Killajoedotcom/Lerdge-iX/Pictures/With Pinda.jpg

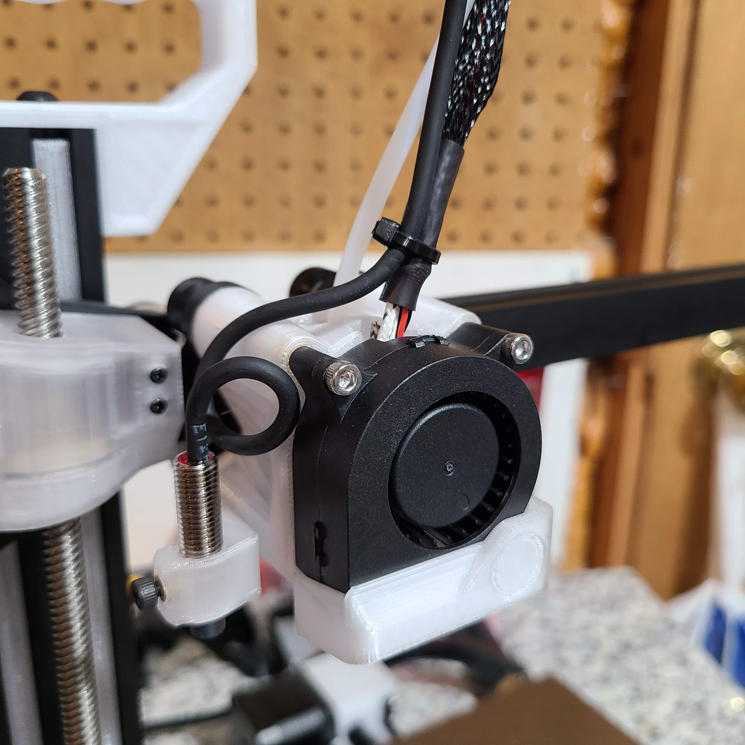
Pictures/With Pinda.jpg
