Killajoedotcom/Lerdge-iX/CAD/Lerdge Z Connections_2048x2048.jpg

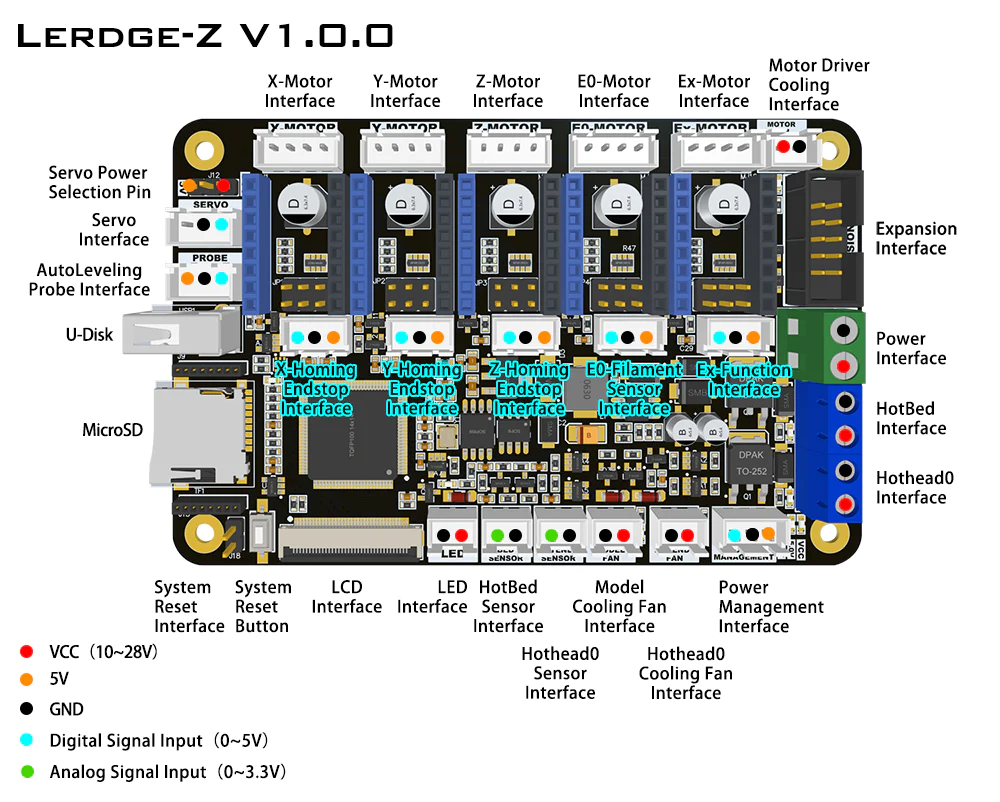
CAD/Lerdge Z Connections_2048x2048.jpg
