Killajoedotcom/Lerdge-iX/README.md

# Lerdge-iX
A repo for my Klipperized Lerdge iX
