Killajoedotcom/Lerdge-iX/CAD/3.5_screen_size-1000_2048x2048.jpg

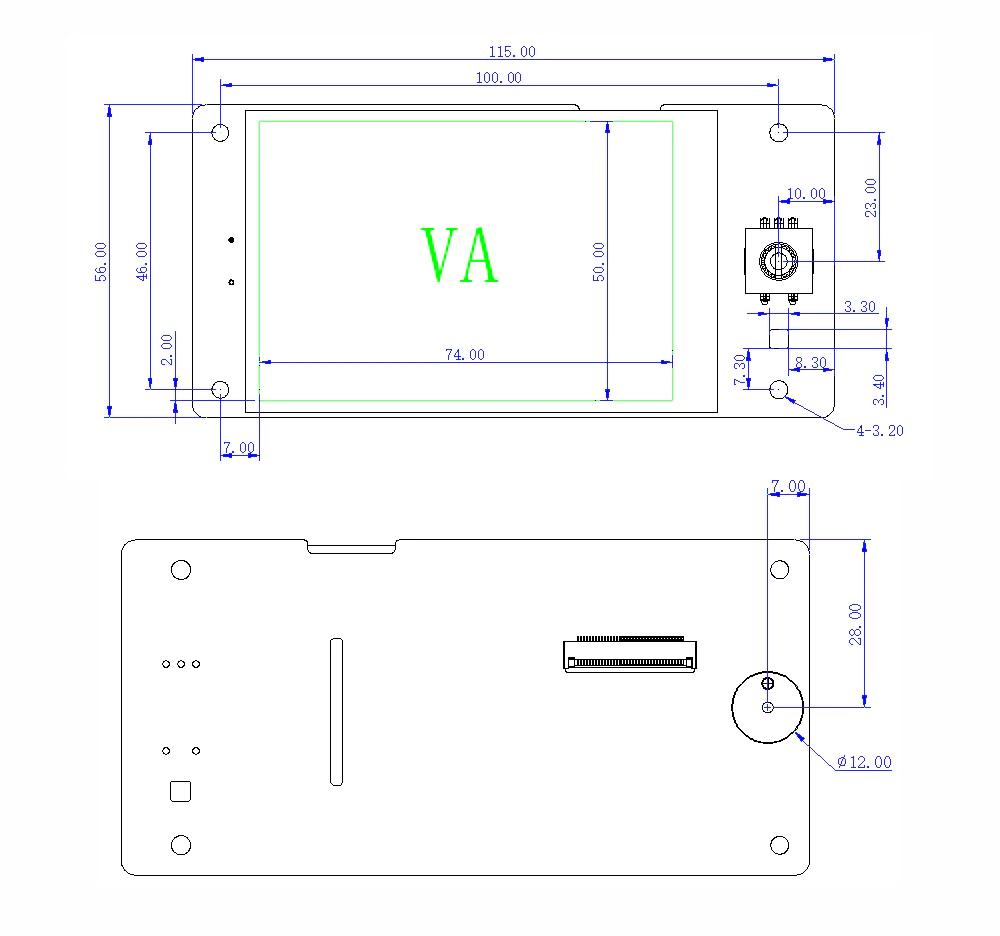
CAD/3.5_screen_size-1000_2048x2048.jpg
