Killajoedotcom/Lerdge-iX/Docs/Lerdge-Z-size-1000_2048x2048.jpg

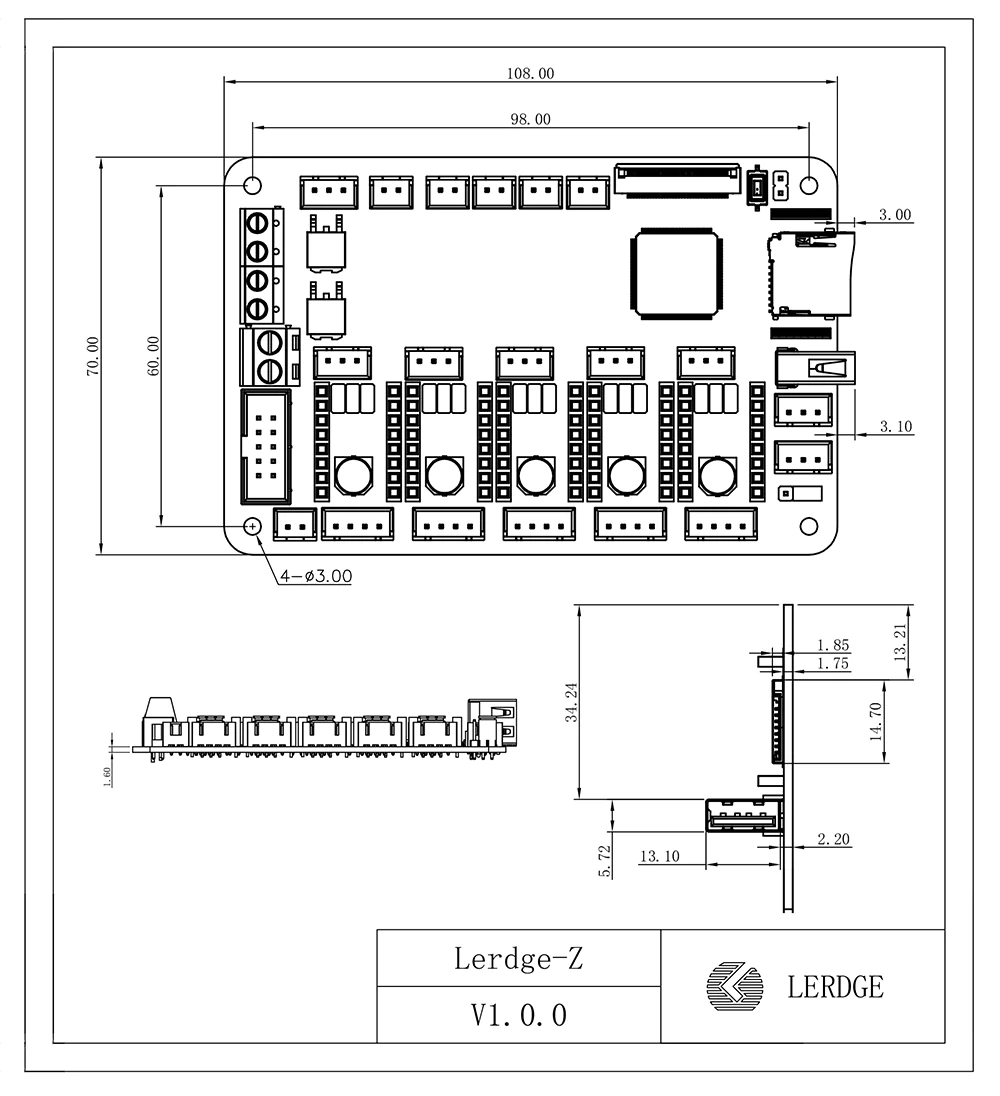
Docs/Lerdge-Z-size-1000_2048x2048.jpg
