Killajoedotcom/Lerdge-iX/Pictures/Toolhead 2.PNG

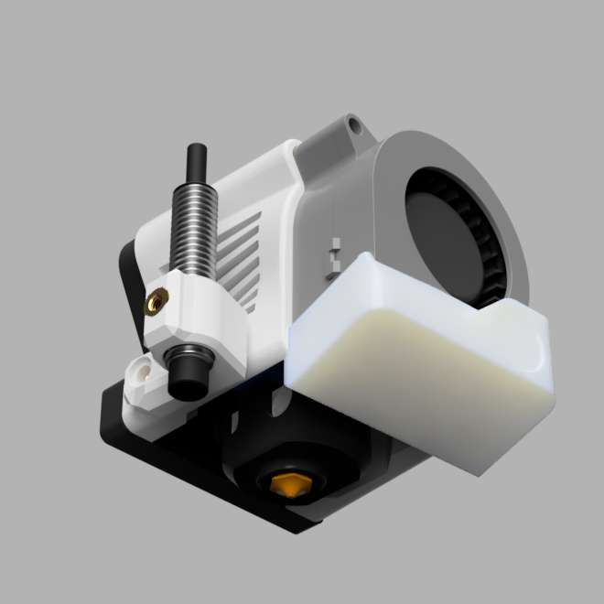
Pictures/Toolhead 2.PNG
