Killajoedotcom/Lerdge-iX/Pictures/Toolhead 3.PNG

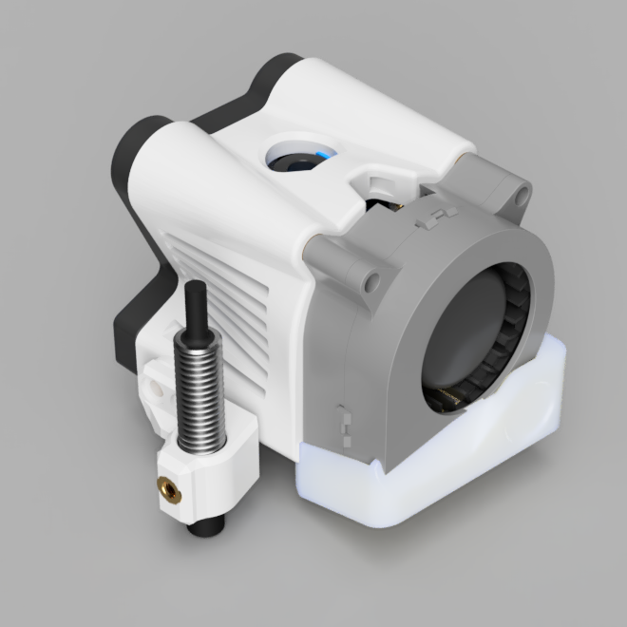
Pictures/Toolhead 3.PNG
