Killajoedotcom/Lerdge-iX/Pictures/Toolhead.PNG

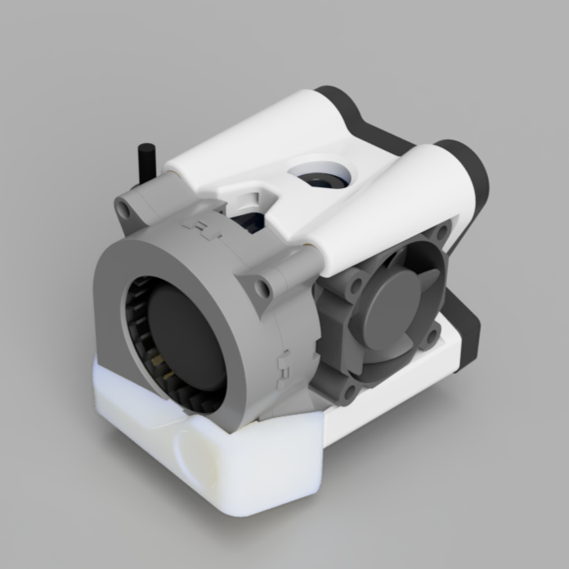
Pictures/Toolhead.PNG
