Killajoedotcom/Lerdge-iX/CAD/13 Filament guide block v6.step

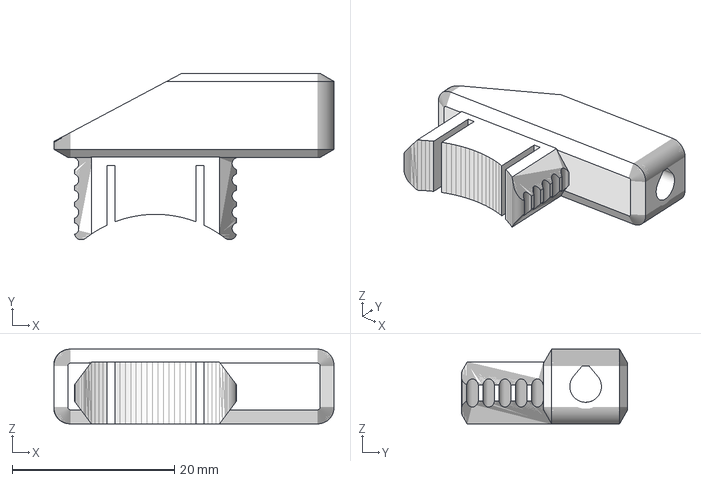
[picture p10: CAD file, 2022-11-13]
CAD/13 Filament guide block v6.step
34.5 x 20.5 x 9.20 mm
