Killajoedotcom/Lerdge-iX/STLs/15 Part Cooling Fan_w_inserts.3mf

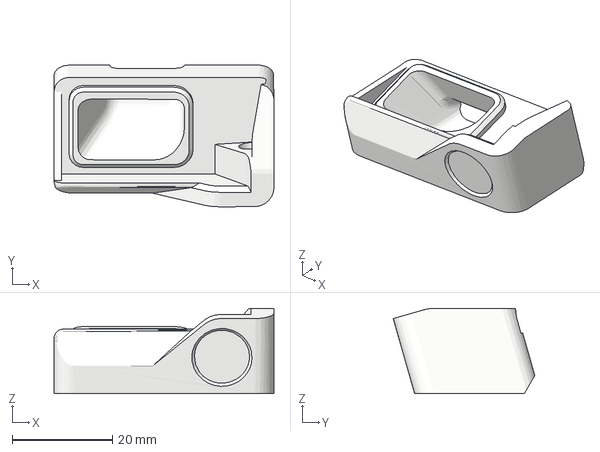
[picture p11: CAD file, 2022-11-11]
STLs/15 Part Cooling Fan_w_inserts.3mf
43.8 x 28.2 x 17.0 mm
