Killajoedotcom/Lerdge-iX/STLs/18 Power box cover.stl

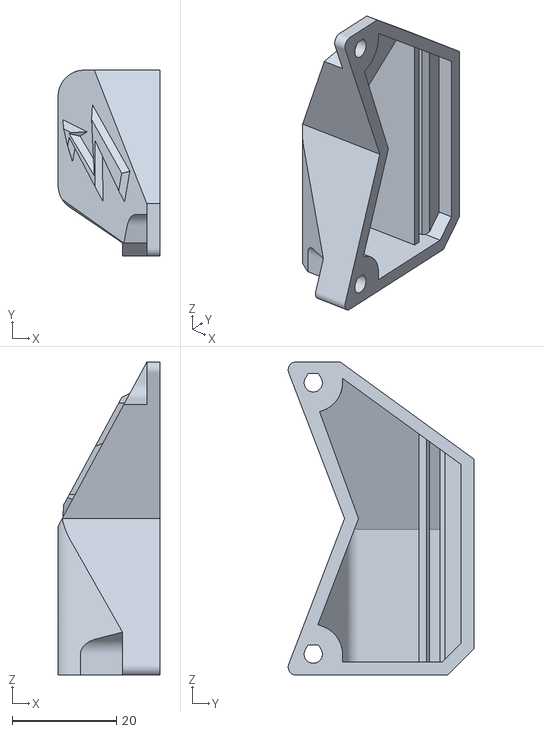
[picture p12: CAD file, 2022-11-11]
STLs/18 Power box cover.stl
19.5 x 35.6 x 60.0
