Killajoedotcom/Lerdge-iX/STLs/7 Z-axis motor adjustment block.stl

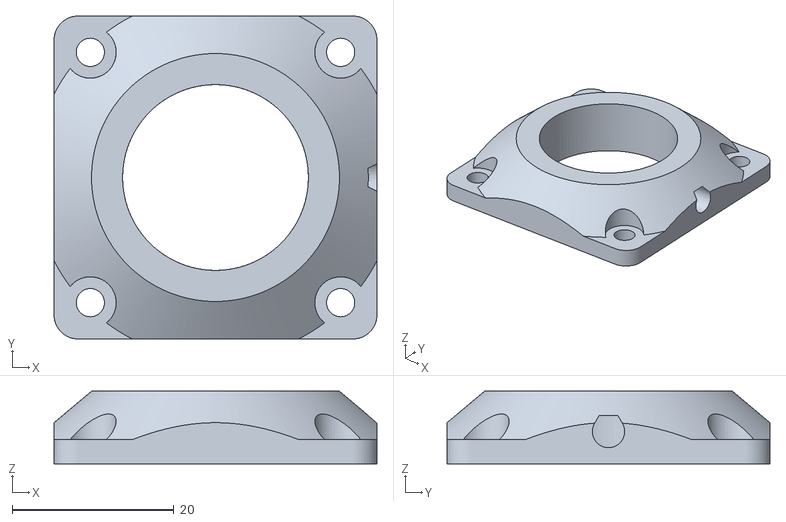
[picture p13: CAD file, 2022-11-11]
STLs/7 Z-axis motor adjustment block.stl
40.0 x 40.0 x 9.00
