Killajoedotcom/Lerdge-iX/CAD/11 X-axis idler base v7.step

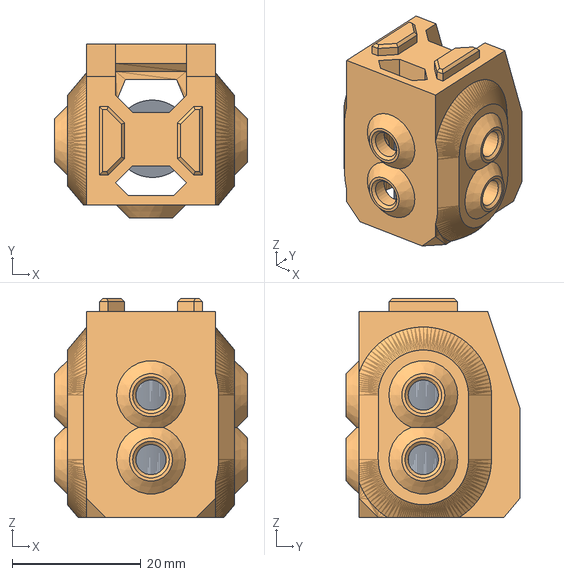
[picture p14: CAD file, 2022-11-13]
CAD/11 X-axis idler base v7.step
30.0 x 27.0 x 34.0 mm
