Killajoedotcom/Lerdge-iX/STLs/8 Z-axis homing probe base.stl

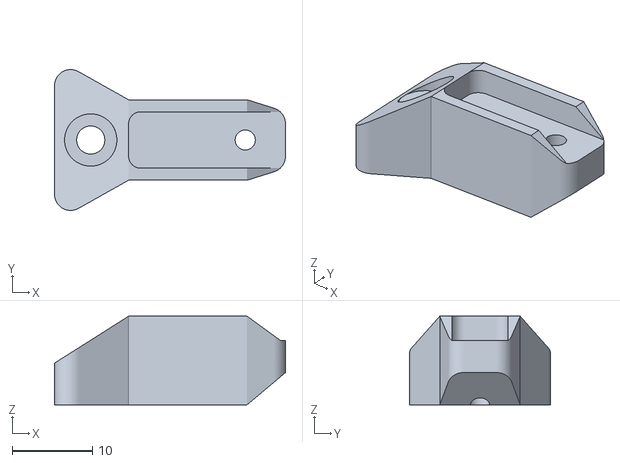
[picture p15: CAD file, 2022-11-11]
STLs/8 Z-axis homing probe base.stl
28.7 x 17.5 x 11.0
