Killajoedotcom/Lerdge-iX/STLs/14 Printhead_w_inserts.3mf

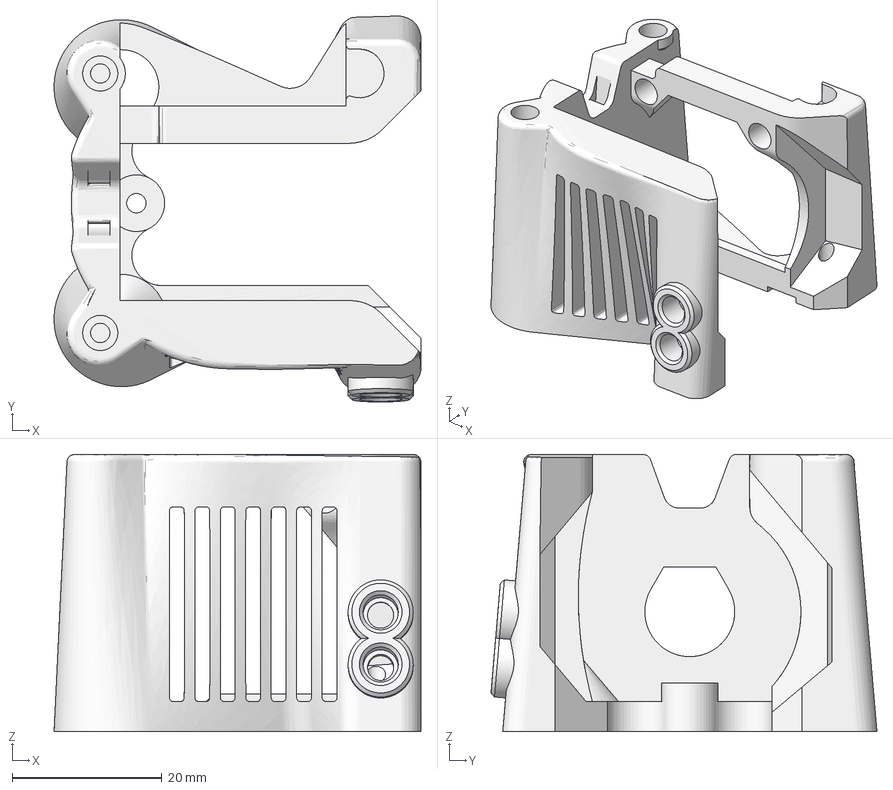
[picture p16: CAD file, 2022-11-11]
STLs/14 Printhead_w_inserts.3mf
49.0 x 51.5 x 37.0 mm
