Killajoedotcom/Lerdge-iX/STLs/17 Power Box.stl

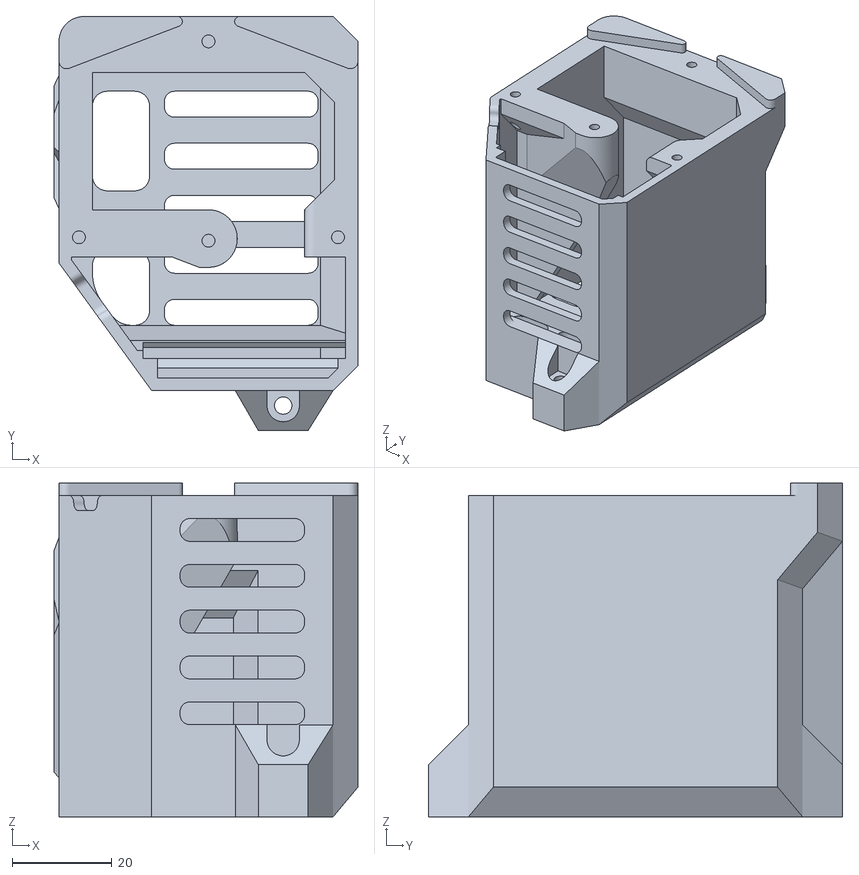
[picture p17: CAD file, 2022-11-11]
STLs/17 Power Box.stl
61.0 x 83.1 x 67.0
