Killajoedotcom/Lerdge-iX/STLs/23 Switch bracket.stl

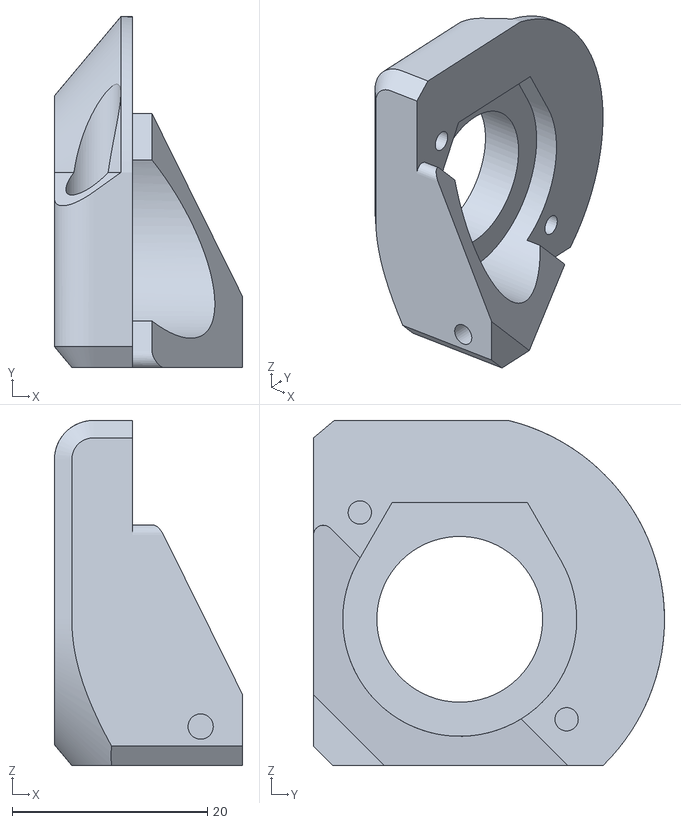
[picture p18: CAD file, 2022-11-11]
STLs/23 Switch bracket.stl
19.3 x 36.0 x 35.4
