Killajoedotcom/Lerdge-iX/STLs/13 Filament guide block.stl

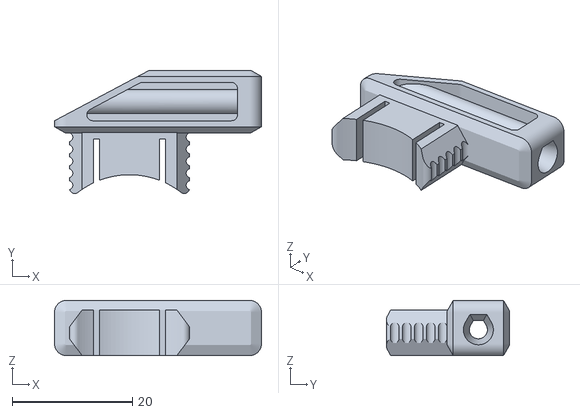
[picture p19: CAD file, 2022-11-11]
STLs/13 Filament guide block.stl
34.5 x 20.5 x 9.20
