Killajoedotcom/Lerdge-iX/STLs/16 Drag chain lead frame.stl

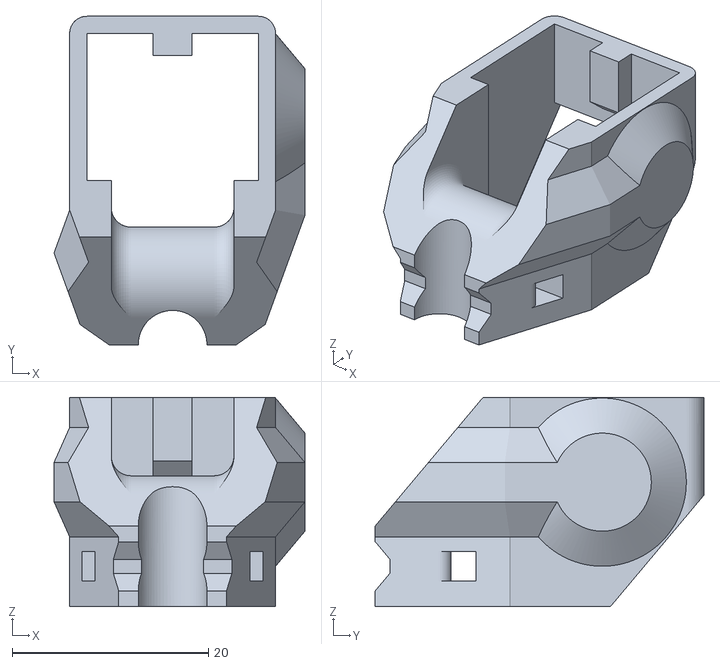
[picture p20: CAD file, 2022-11-11]
STLs/16 Drag chain lead frame.stl
25.6 x 33.5 x 21.3
