Killajoedotcom/Lerdge-iX/STLs/14.5 Probe Mount.3mf

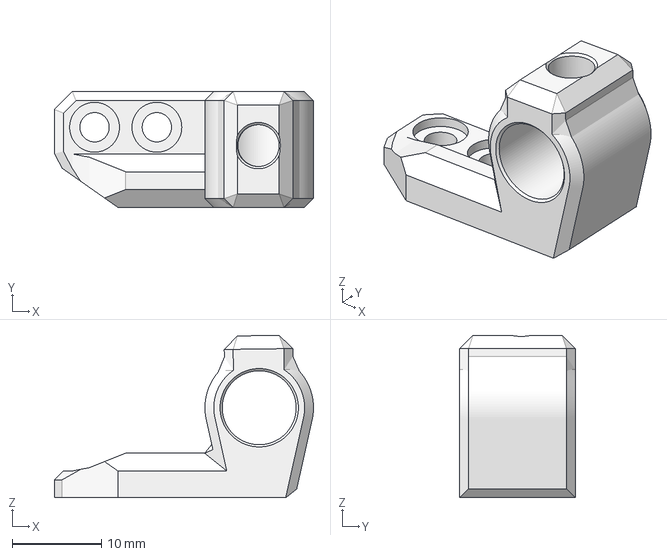
[picture p21: CAD file, 2022-11-11]
STLs/14.5 Probe Mount.3mf
29.1 x 13.0 x 18.2 mm
