Killajoedotcom/Lerdge-iX/STLs/22 LCD panel.stl

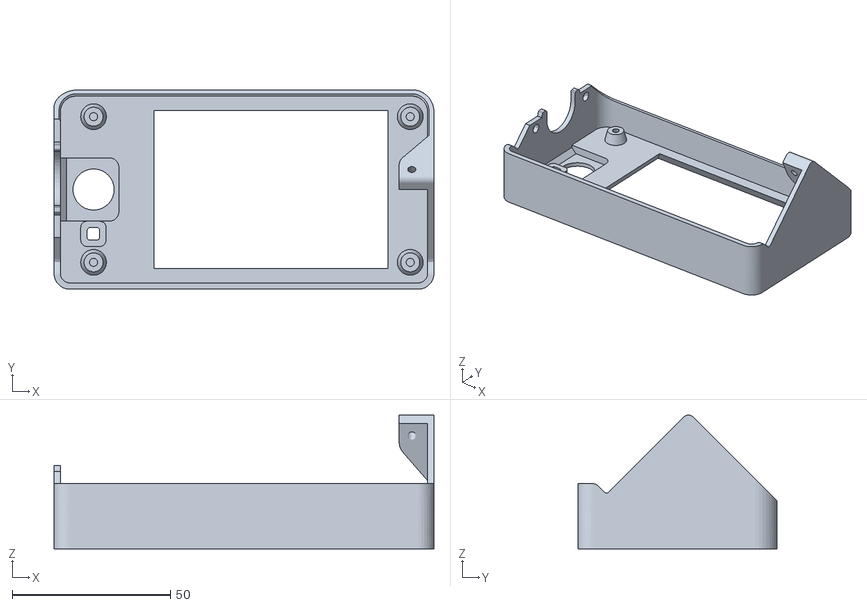
[picture p22: CAD file, 2022-11-11]
STLs/22 LCD panel.stl
120.0 x 63.0 x 42.3
