Killajoedotcom/Lerdge-iX/STLs/6 Z-axis motor base.stl

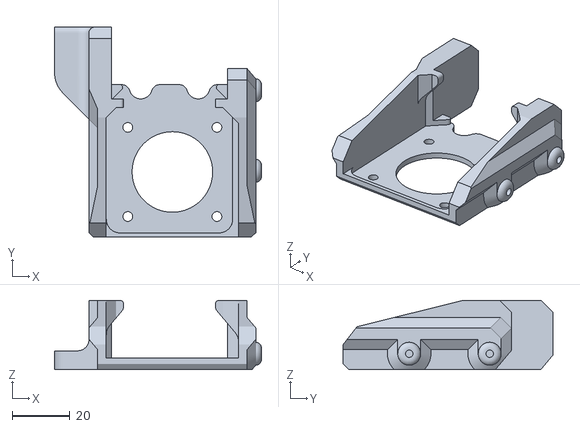
[picture p23: CAD file, 2022-11-11]
STLs/6 Z-axis motor base.stl
72.0 x 73.0 x 24.0
