Killajoedotcom/Lerdge-iX/STLs/20 300W Power Shell Top.stl

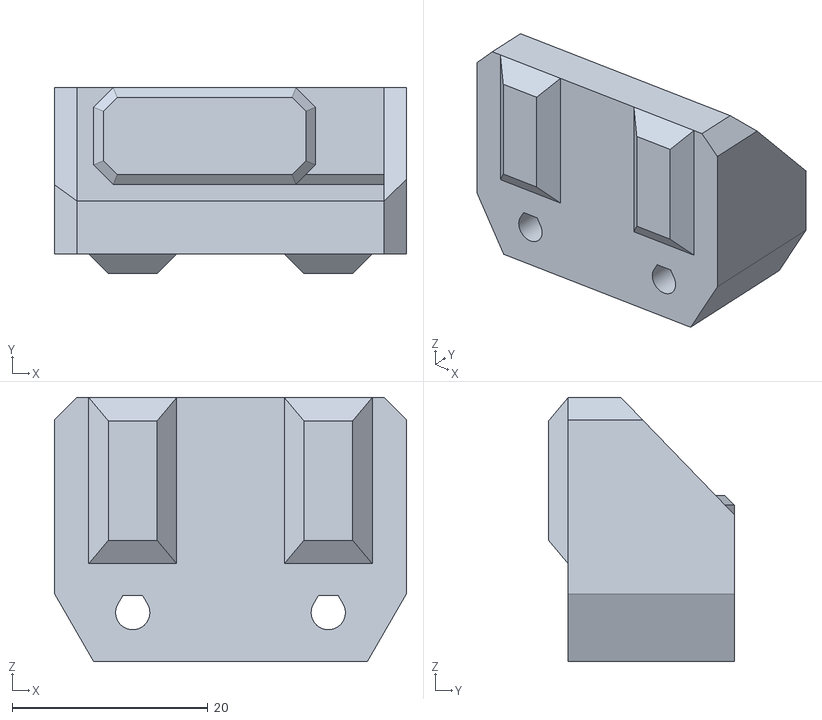
[picture p24: CAD file, 2022-11-11]
STLs/20 300W Power Shell Top.stl
36.0 x 19.0 x 27.0
