Killajoedotcom/Lerdge-iX/STLs/24 Drive cooling air guide.stl

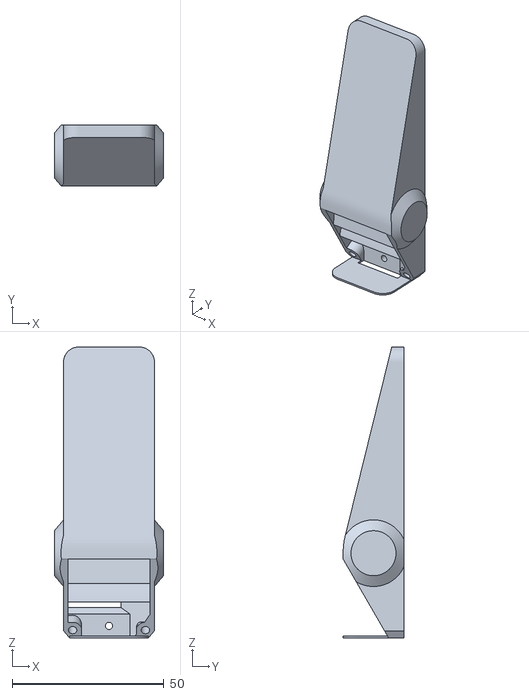
[picture p25: CAD file, 2022-11-11]
STLs/24 Drive cooling air guide.stl
36.0 x 20.0 x 96.0
