Killajoedotcom/Lerdge-iX/STLs/21 Motherboard panel.stl

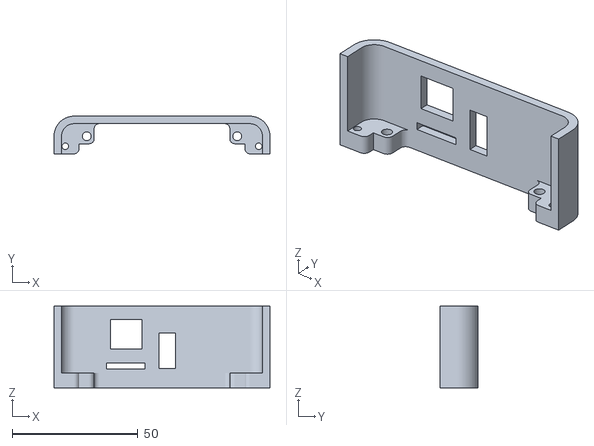
[picture p26: CAD file, 2022-11-11]
STLs/21 Motherboard panel.stl
86.0 x 15.0 x 32.6
