Killajoedotcom/Lerdge-iX/STLs/12 X-axis belt fixing block.stl

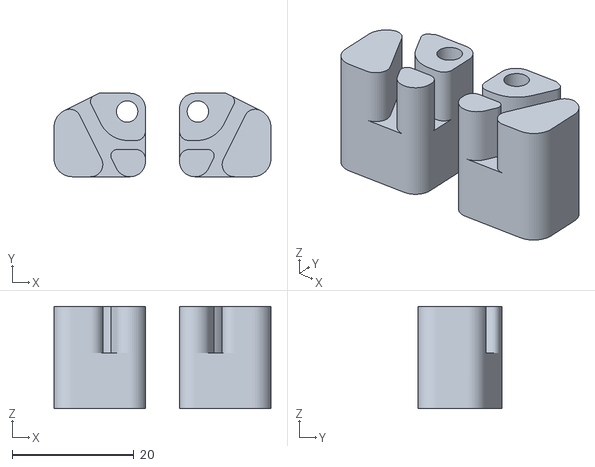
[picture p27: CAD file, 2022-11-11]
STLs/12 X-axis belt fixing block.stl
35.6 x 13.7 x 16.8
