Killajoedotcom/Lerdge-iX/STLs/3 Y-axis idler base.stl

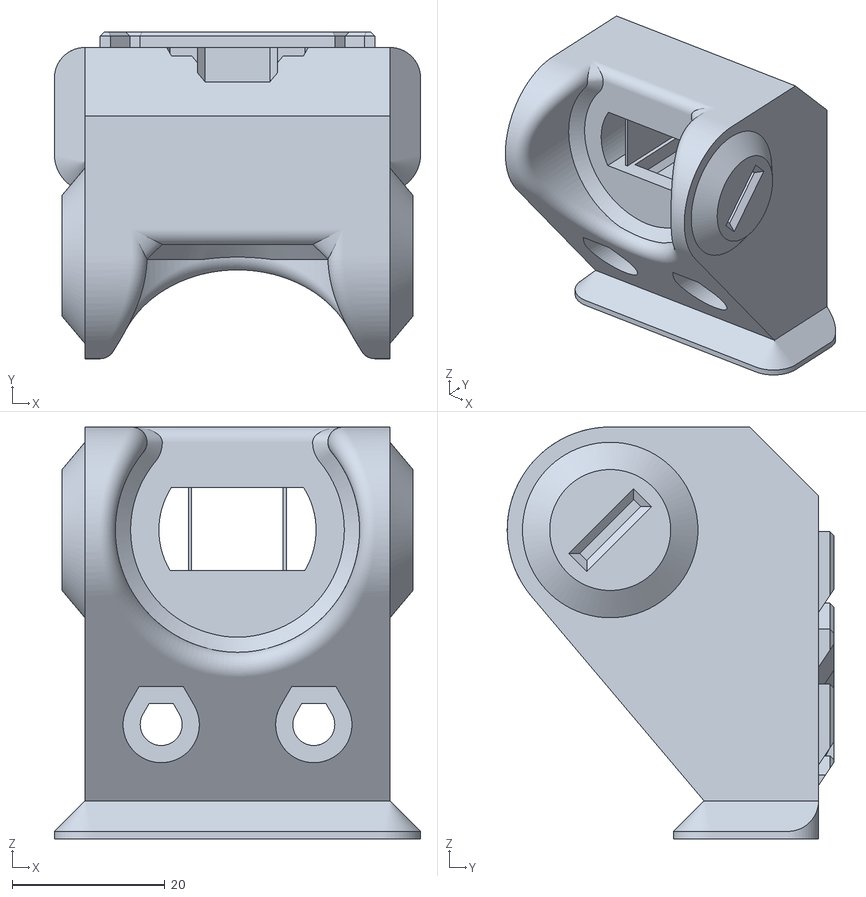
[picture p28: CAD file, 2022-11-11]
STLs/3 Y-axis idler base.stl
48.0 x 42.8 x 54.0
