Killajoedotcom/Lerdge-iX/STLs/25 handle.stl

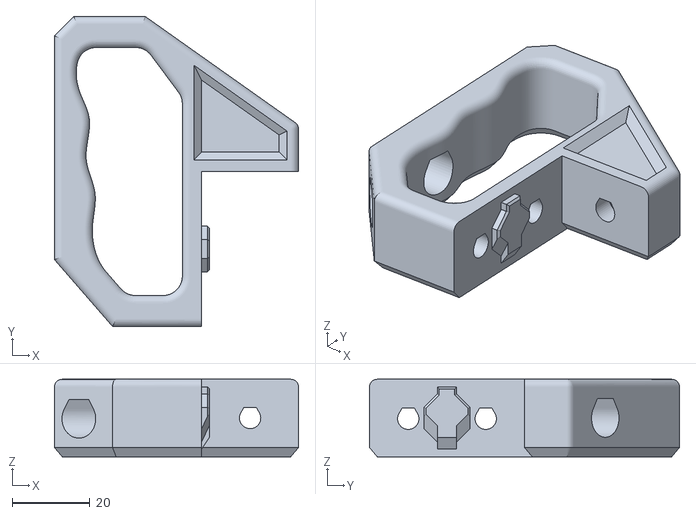
[picture p29: CAD file, 2022-11-11]
STLs/25 handle.stl
63.0 x 80.0 x 20.0
