Killajoedotcom/Lerdge-iX/STLs/9 Z-axis home probe stopper.stl

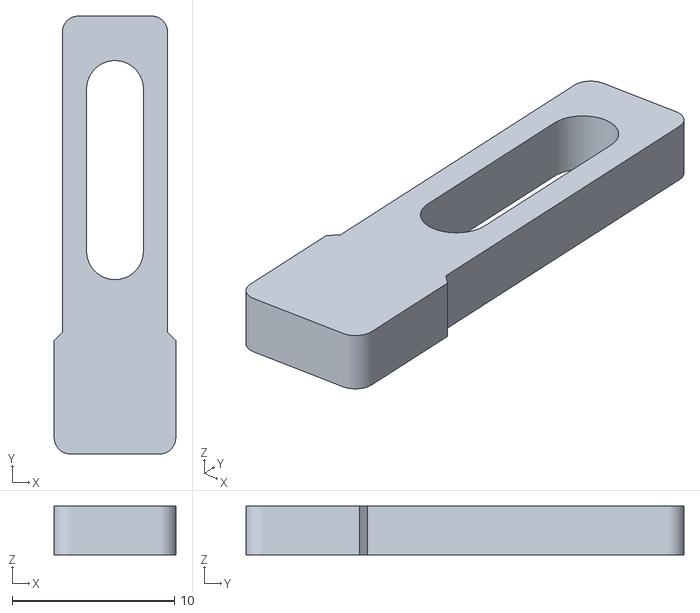
[picture p30: CAD file, 2022-11-11]
STLs/9 Z-axis home probe stopper.stl
7.50 x 27.0 x 3.00
