Killajoedotcom/Lerdge-iX/STLs/4 Y-axis motor base.stl

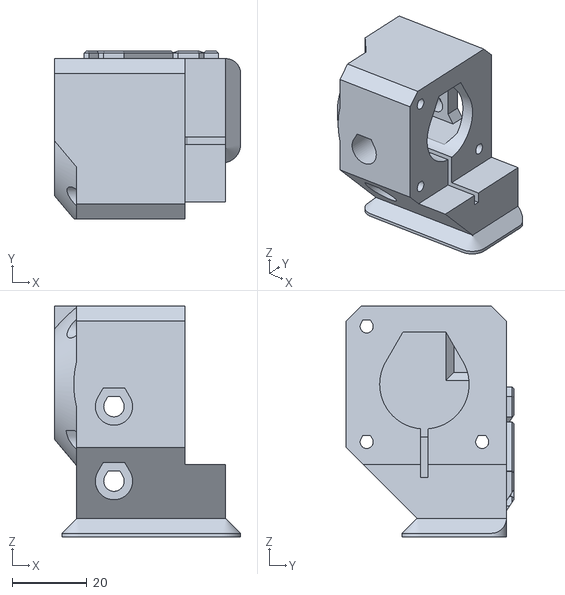
[picture p31: CAD file, 2022-11-11]
STLs/4 Y-axis motor base.stl
50.0 x 45.0 x 62.0
