Killajoedotcom/Lerdge-iX/STLs/5 Z-axis drag chain base.stl

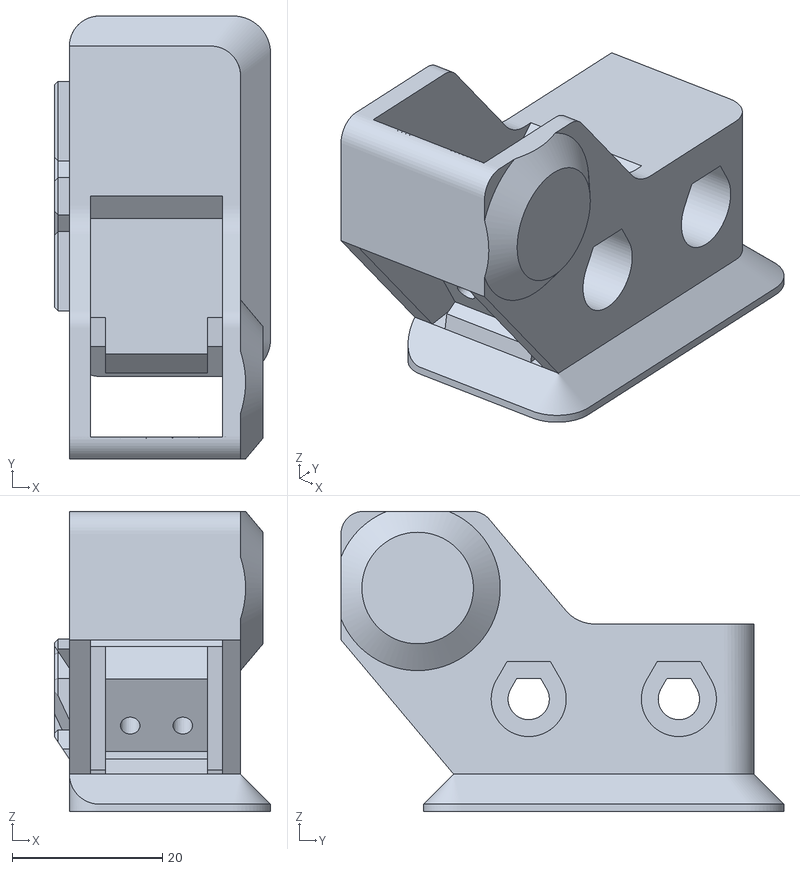
[picture p32: CAD file, 2022-11-11]
STLs/5 Z-axis drag chain base.stl
28.8 x 59.0 x 40.0
