Killajoedotcom/Lerdge-iX/STLs/14 Printhead fan bracket.stl

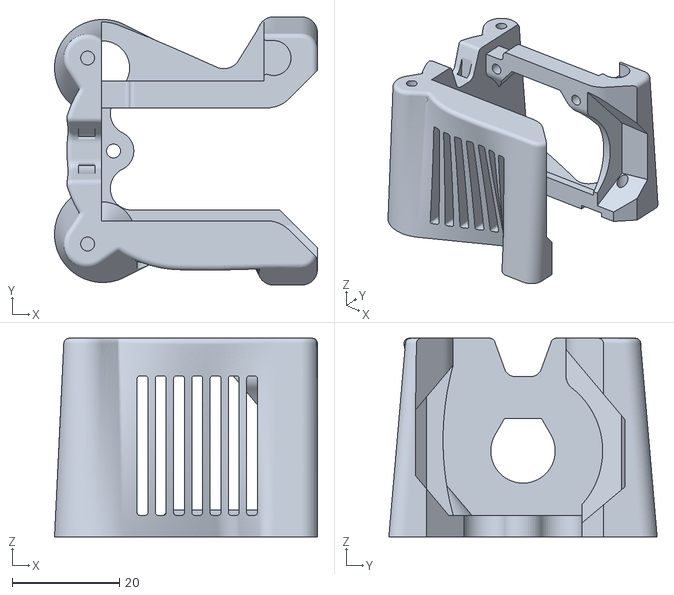
[picture p33: CAD file, 2022-11-11]
STLs/14 Printhead fan bracket.stl
49.0 x 50.0 x 37.0
