Killajoedotcom/Lerdge-iX/STLs/1 Idler pulley frame (two).stl

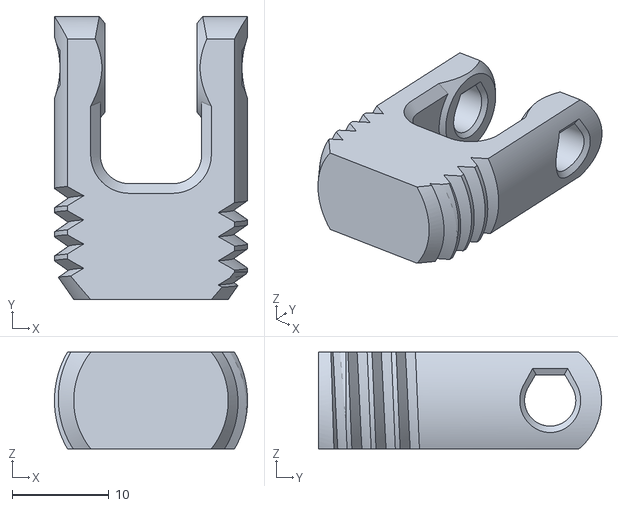
[picture p34: CAD file, 2022-11-11]
STLs/1 Idler pulley frame (two).stl
20.0 x 29.3 x 10.0
