Killajoedotcom/Lerdge-iX/STLs/20 300W Power Shell Bottom.stl

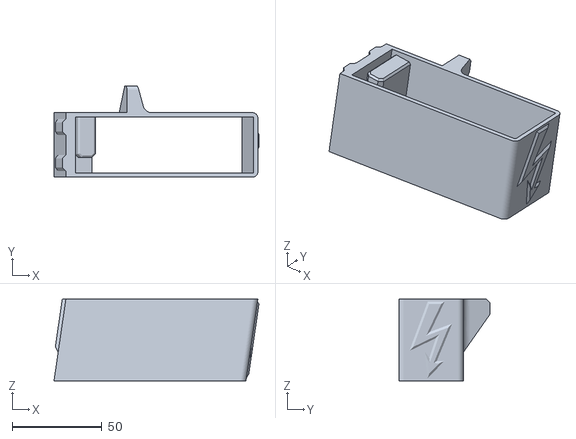
[picture p35: CAD file, 2022-11-11]
STLs/20 300W Power Shell Bottom.stl
114.4 x 51.0 x 45.5
