Killajoedotcom/Lerdge-iX/STLs/11 X-axis idler base.stl

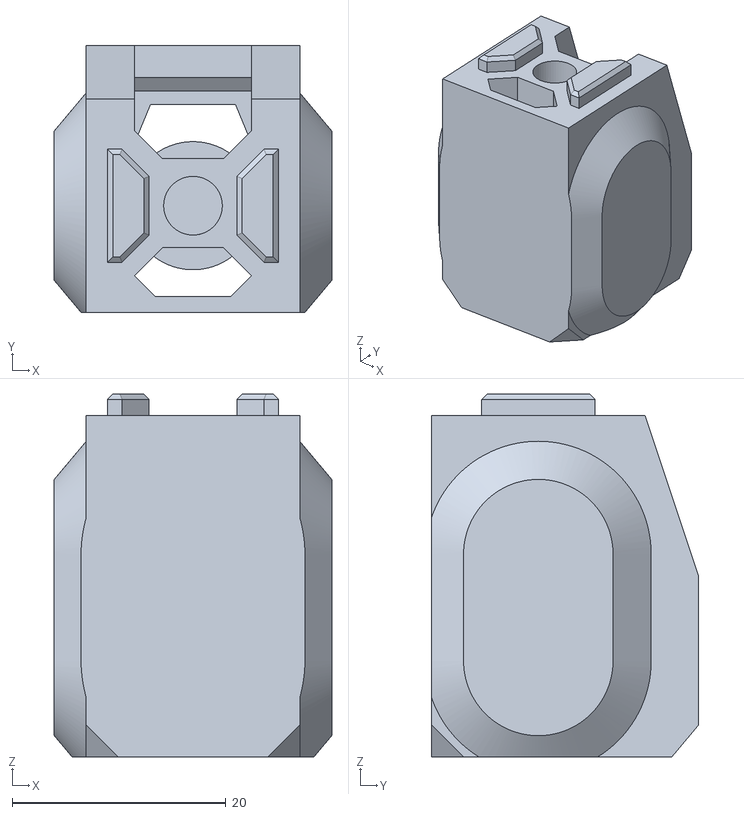
[picture p36: CAD file, 2022-11-11]
STLs/11 X-axis idler base.stl
26.0 x 25.0 x 34.0
