Killajoedotcom/Lerdge-iX/STLs/10 X-axis motor cover.stl

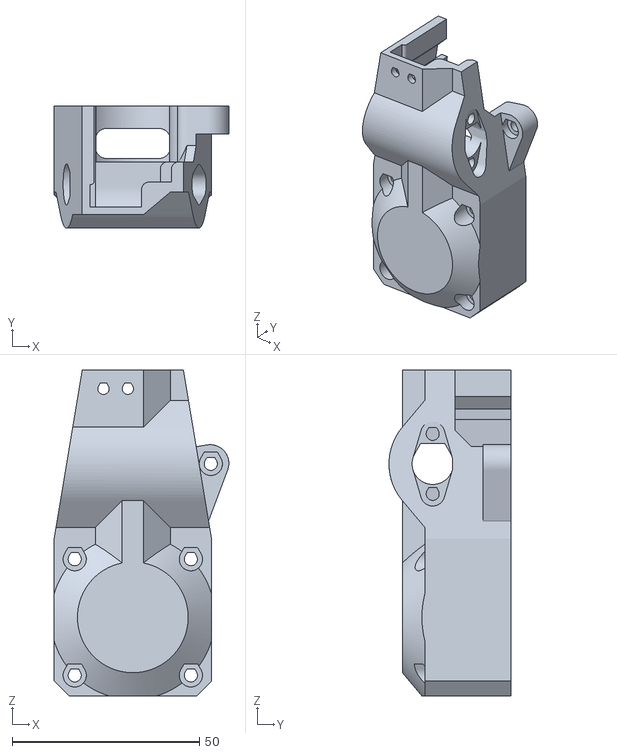
[picture p37: CAD file, 2022-11-11]
STLs/10 X-axis motor cover.stl
46.6 x 32.6 x 87.0
