Killajoedotcom/Lerdge-iX/STLs/2 Idler adjustment knob (two).stl

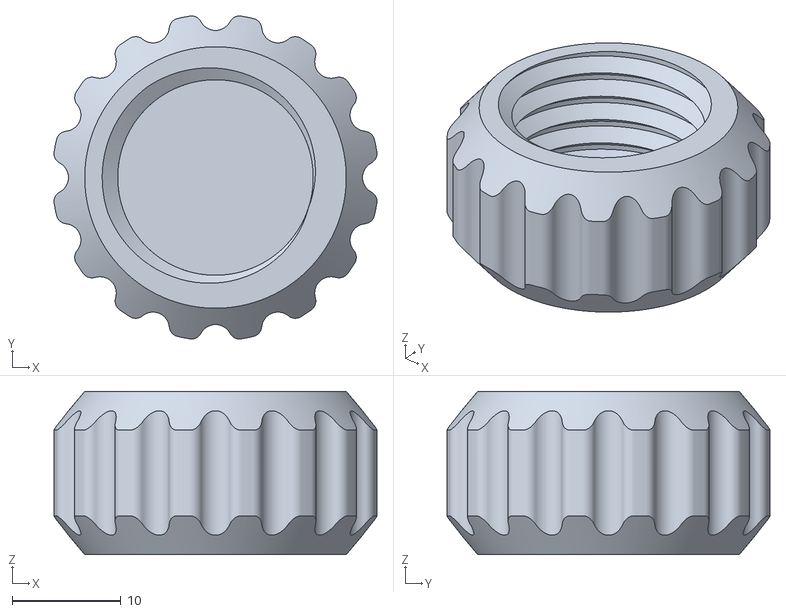
[picture p38: CAD file, 2022-11-11]
STLs/2 Idler adjustment knob (two).stl
29.6 x 29.6 x 15.0
