Killajoedotcom/Lerdge-iX/(list of files, cad)

Other CAD files:
CAD/X-axis slider plate (Hole version).dwg
CAD/Printer bottom plate.dwg
STLs/15 Model cooling air outlet.stl
CAD/X-axis slider plate (Thread version).dwg
