Killajoedotcom/Lerdge-iX/CAD/Printer Bottom Plate.pdf

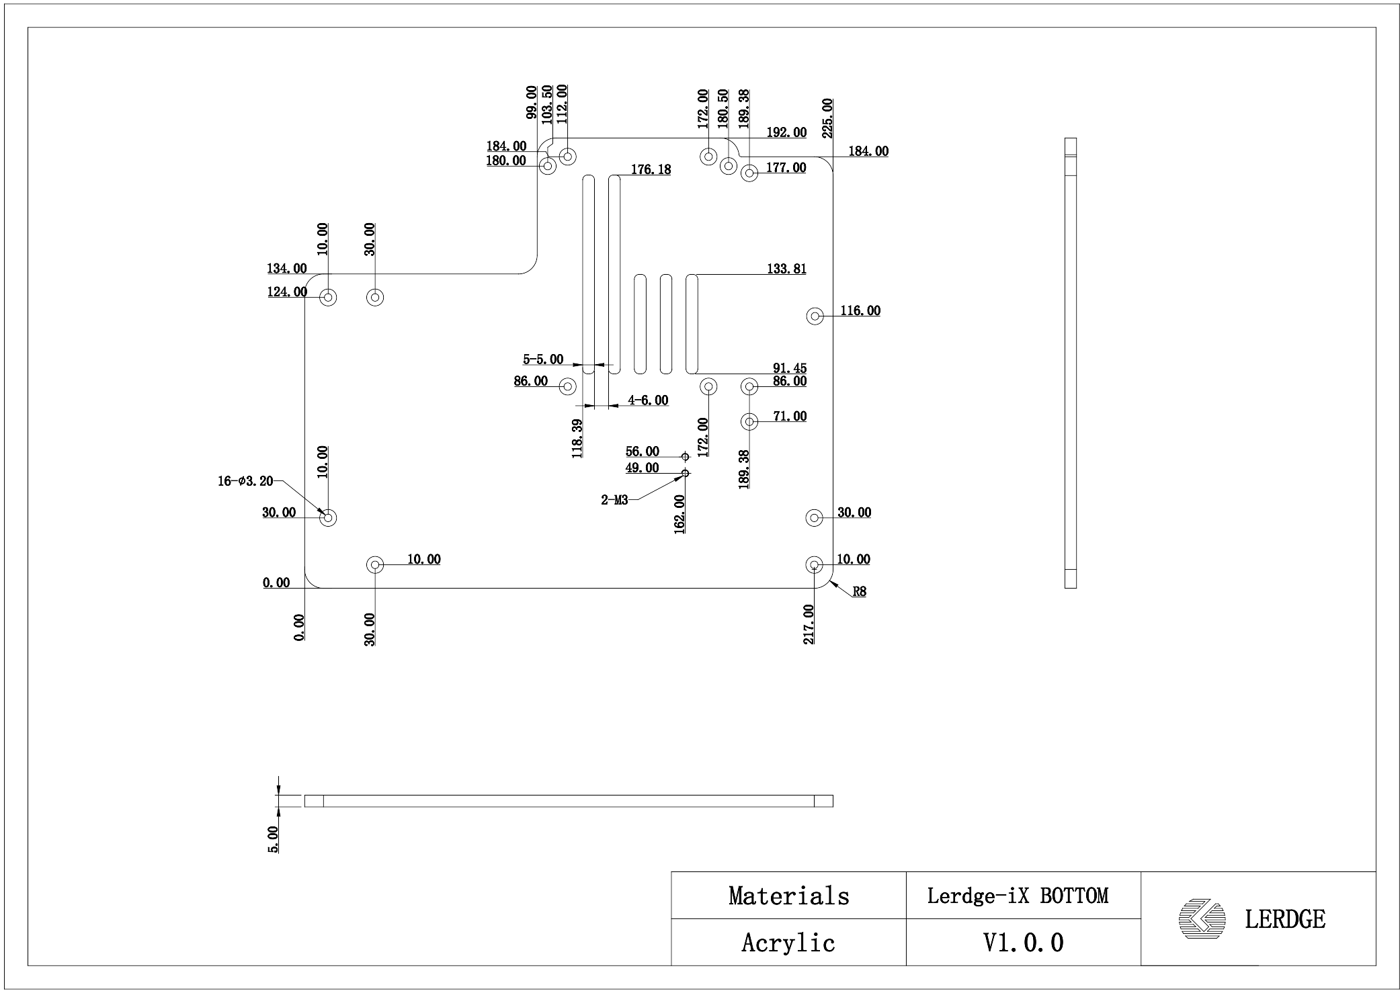
[picture p52: page 1]
