Killajoedotcom/Lerdge-iX/(commit log)

2022-11-11 Add files via upload
    Initial dump of STLs. Some w/ inserts were remixed for easy hotend disassembly.
    [1 Idler pulley frame (two).stl, 10 X-axis motor cover.stl, 11 X-axis idler base.stl, 12 X-axis belt fixing block.stl, 13 Filament guide block.stl, 14 Printhead fan bracket.stl, 14 Printhead_w_inserts.3mf, 14.5 Probe Mount.3mf]
2022-11-13 Directory Cleanup
    Sorted things a bit better
    [1 Idler pulley frame (two).stl, 10 X-axis motor cover.stl, 11 X-axis idler base v7.step, 11 X-axis idler base.stl, 12 X-axis belt fixing block.stl, 13 Filament guide block v6.step, 13 Filament guide block.stl, 14 Printhead fan bracket.stl]
